kkudrolli/Team-SDK-545/background.bmp

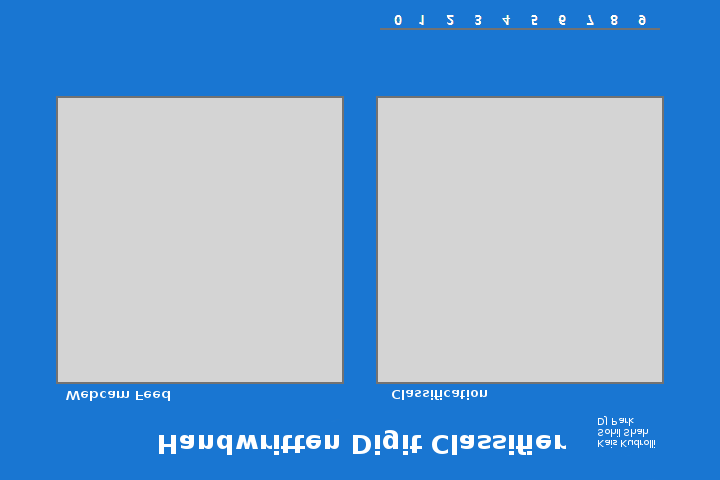
background.bmp
