kkudrolli/Team-SDK-545/labs/lab1_1/sources/lab1_top.v

`timescale 1ns / 1ps
//////////////////////////////////////////////////////////////////////////////////
// Company: 
// Engineer: 
// 
// Create Date: 09/05/2015 11:21:27 AM
// Design Name: 
// Module Name: lab1_top
// Project Name: 
// Target Devices: 
// Tool Versions: 
// Description: 
// 
// Dependencies: 
// 
// Revision:
// Revision 0.01 - File Created
// Additional Comments:
// 
//////////////////////////////////////////////////////////////////////////////////


module lab1_top(
    input logic [3:0] A,B,
    output logic [3:0] C
    );
    
    assign C = A^B;
endmodule
