kkudrolli/Team-SDK-545/rtl/hdmi/constriants/pin.xdc

set_property PACKAGE_PIN AU23 [get_ports HDMI_TX_CLK]
set_property IOSTANDARD LVCMOS18 [get_ports HDMI_TX_CLK]
set_property PACKAGE_PIN AP21 [get_ports HDMI_TX_DE]
set_property IOSTANDARD LVCMOS18 [get_ports HDMI_TX_DE]
set_property IOSTANDARD LVCMOS18 [get_ports HDMI_TX_HS]
set_property PACKAGE_PIN AT22 [get_ports HDMI_TX_VS]
set_property IOSTANDARD LVCMOS18 [get_ports HDMI_TX_VS]
set_property PACKAGE_PIN AU22 [get_ports HDMI_TX_HS]
set_property PACKAGE_PIN AT35 [get_ports I2C_SCL]
set_property IOSTANDARD LVCMOS18 [get_ports I2C_SCL]
set_property PACKAGE_PIN AU32 [get_ports I2C_SDA]
set_property IOSTANDARD LVCMOS18 [get_ports I2C_SDA]
set_property PACKAGE_PIN E19 [get_ports SYSCLK_P]
set_property IOSTANDARD LVDS [get_ports SYSCLK_P]
set_property PACKAGE_PIN AV39 [get_ports rst]
set_property IOSTANDARD LVCMOS18 [get_ports rst]

set_property PACKAGE_PIN AM22 [get_ports {HDMI_TX_D[0]}]
set_property IOSTANDARD LVCMOS18 [get_ports {HDMI_TX_D[0]}]
set_property PACKAGE_PIN AL22 [get_ports {HDMI_TX_D[1]}]
set_property IOSTANDARD LVCMOS18 [get_ports {HDMI_TX_D[1]}]
set_property PACKAGE_PIN AJ20 [get_ports {HDMI_TX_D[2]}]
set_property IOSTANDARD LVCMOS18 [get_ports {HDMI_TX_D[2]}]
set_property PACKAGE_PIN AJ21 [get_ports {HDMI_TX_D[3]}]
set_property IOSTANDARD LVCMOS18 [get_ports {HDMI_TX_D[3]}]
set_property PACKAGE_PIN AM21 [get_ports {HDMI_TX_D[4]}]
set_property IOSTANDARD LVCMOS18 [get_ports {HDMI_TX_D[4]}]
set_property PACKAGE_PIN AL21 [get_ports {HDMI_TX_D[5]}]
set_property IOSTANDARD LVCMOS18 [get_ports {HDMI_TX_D[5]}]
set_property PACKAGE_PIN AK22 [get_ports {HDMI_TX_D[6]}]
set_property IOSTANDARD LVCMOS18 [get_ports {HDMI_TX_D[6]}]
set_property PACKAGE_PIN AJ22 [get_ports {HDMI_TX_D[7]}]
set_property IOSTANDARD LVCMOS18 [get_ports {HDMI_TX_D[7]}]
set_property PACKAGE_PIN AL20 [get_ports {HDMI_TX_D[8]}]
set_property IOSTANDARD LVCMOS18 [get_ports {HDMI_TX_D[8]}]
set_property PACKAGE_PIN AK20 [get_ports {HDMI_TX_D[9]}]
set_property IOSTANDARD LVCMOS18 [get_ports {HDMI_TX_D[9]}]
set_property PACKAGE_PIN AK23 [get_ports {HDMI_TX_D[10]}]
set_property IOSTANDARD LVCMOS18 [get_ports {HDMI_TX_D[10]}]
set_property PACKAGE_PIN AJ23 [get_ports {HDMI_TX_D[11]}]
set_property IOSTANDARD LVCMOS18 [get_ports {HDMI_TX_D[11]}]
set_property PACKAGE_PIN AN21 [get_ports {HDMI_TX_D[12]}]
set_property IOSTANDARD LVCMOS18 [get_ports {HDMI_TX_D[12]}]
set_property PACKAGE_PIN AP22 [get_ports {HDMI_TX_D[13]}]
set_property IOSTANDARD LVCMOS18 [get_ports {HDMI_TX_D[13]}]
set_property PACKAGE_PIN AP23 [get_ports {HDMI_TX_D[14]}]
set_property IOSTANDARD LVCMOS18 [get_ports {HDMI_TX_D[14]}]
set_property PACKAGE_PIN AN23 [get_ports {HDMI_TX_D[15]}]
set_property IOSTANDARD LVCMOS18 [get_ports {HDMI_TX_D[15]}]
set_property PACKAGE_PIN AM23 [get_ports {HDMI_TX_D[16]}]
set_property IOSTANDARD LVCMOS18 [get_ports {HDMI_TX_D[16]}]
set_property PACKAGE_PIN AN24 [get_ports {HDMI_TX_D[17]}]
set_property IOSTANDARD LVCMOS18 [get_ports {HDMI_TX_D[17]}]
set_property PACKAGE_PIN AY24 [get_ports {HDMI_TX_D[18]}]
set_property IOSTANDARD LVCMOS18 [get_ports {HDMI_TX_D[18]}]
set_property PACKAGE_PIN BB22 [get_ports {HDMI_TX_D[19]}]
set_property IOSTANDARD LVCMOS18 [get_ports {HDMI_TX_D[19]}]
set_property PACKAGE_PIN BA22 [get_ports {HDMI_TX_D[20]}]
set_property IOSTANDARD LVCMOS18 [get_ports {HDMI_TX_D[20]}]
set_property PACKAGE_PIN BA25 [get_ports {HDMI_TX_D[21]}]
set_property IOSTANDARD LVCMOS18 [get_ports {HDMI_TX_D[21]}]
set_property PACKAGE_PIN AY25 [get_ports {HDMI_TX_D[22]}]
set_property IOSTANDARD LVCMOS18 [get_ports {HDMI_TX_D[22]}]
set_property PACKAGE_PIN AY22 [get_ports {HDMI_TX_D[23]}]
set_property IOSTANDARD LVCMOS18 [get_ports {HDMI_TX_D[23]}]
set_property PACKAGE_PIN AY23 [get_ports {HDMI_TX_D[24]}]
set_property IOSTANDARD LVCMOS18 [get_ports {HDMI_TX_D[24]}]
set_property PACKAGE_PIN AV24 [get_ports {HDMI_TX_D[25]}]
set_property IOSTANDARD LVCMOS18 [get_ports {HDMI_TX_D[25]}]
set_property PACKAGE_PIN AU24 [get_ports {HDMI_TX_D[26]}]
set_property IOSTANDARD LVCMOS18 [get_ports {HDMI_TX_D[26]}]
set_property PACKAGE_PIN AW21 [get_ports {HDMI_TX_D[27]}]
set_property IOSTANDARD LVCMOS18 [get_ports {HDMI_TX_D[27]}]
set_property PACKAGE_PIN AV21 [get_ports {HDMI_TX_D[28]}]
set_property IOSTANDARD LVCMOS18 [get_ports {HDMI_TX_D[28]}]
set_property PACKAGE_PIN AT24 [get_ports {HDMI_TX_D[29]}]
set_property IOSTANDARD LVCMOS18 [get_ports {HDMI_TX_D[29]}]
set_property PACKAGE_PIN AR24 [get_ports {HDMI_TX_D[30]}]
set_property IOSTANDARD LVCMOS18 [get_ports {HDMI_TX_D[30]}]
set_property PACKAGE_PIN AU21 [get_ports {HDMI_TX_D[31]}]
set_property IOSTANDARD LVCMOS18 [get_ports {HDMI_TX_D[31]}]
set_property PACKAGE_PIN AT21 [get_ports {HDMI_TX_D[32]}]
set_property IOSTANDARD LVCMOS18 [get_ports {HDMI_TX_D[32]}]
set_property PACKAGE_PIN AW22 [get_ports {HDMI_TX_D[33]}]
set_property IOSTANDARD LVCMOS18 [get_ports {HDMI_TX_D[33]}]
set_property PACKAGE_PIN AW23 [get_ports {HDMI_TX_D[34]}]
set_property IOSTANDARD LVCMOS18 [get_ports {HDMI_TX_D[34]}]
set_property PACKAGE_PIN AV23 [get_ports {HDMI_TX_D[35]}]
set_property IOSTANDARD LVCMOS18 [get_ports {HDMI_TX_D[35]}]
