kkudrolli/Team-SDK-545/labs/lab1_1/constraints/lab1_const.xdc

set_property IOSTANDARD LVDCI_18 [get_ports {A[3]}]
set_property IOSTANDARD LVDCI_18 [get_ports {A[2]}]
set_property IOSTANDARD LVDCI_18 [get_ports {A[1]}]
set_property IOSTANDARD LVDCI_18 [get_ports {A[0]}]
set_property IOSTANDARD LVDCI_18 [get_ports {B[3]}]
set_property IOSTANDARD LVDCI_18 [get_ports {B[2]}]
set_property IOSTANDARD LVDCI_18 [get_ports {B[1]}]
set_property IOSTANDARD LVDCI_18 [get_ports {B[0]}]
set_property PACKAGE_PIN AV30 [get_ports {A[3]}]
set_property PACKAGE_PIN AY33 [get_ports {A[2]}]
set_property PACKAGE_PIN BA31 [get_ports {A[1]}]
set_property PACKAGE_PIN BA32 [get_ports {A[0]}]
set_property PACKAGE_PIN AW30 [get_ports {B[3]}]
set_property PACKAGE_PIN AY30 [get_ports {B[2]}]
set_property PACKAGE_PIN BA30 [get_ports {B[1]}]
set_property PACKAGE_PIN BB31 [get_ports {B[0]}]
set_property PACKAGE_PIN AM39 [get_ports {C[3]}]
set_property PACKAGE_PIN AN39 [get_ports {C[2]}]
set_property PACKAGE_PIN AR37 [get_ports {C[1]}]
set_property PACKAGE_PIN AT37 [get_ports {C[0]}]
set_property IOSTANDARD LVCMOS18 [get_ports {C[3]}]
set_property IOSTANDARD LVCMOS18 [get_ports {C[2]}]
set_property IOSTANDARD LVCMOS18 [get_ports {C[1]}]
set_property IOSTANDARD LVCMOS18 [get_ports {C[0]}]
