kkudrolli/Team-SDK-545/labs/lab1_2/constraints/pin.xdc

set_property IOSTANDARD LVCMOS18 [get_ports GPIO_SW_C]
set_property IOSTANDARD LVCMOS18 [get_ports GPIO_SW_E]
set_property IOSTANDARD LVCMOS18 [get_ports GPIO_SW_S]
set_property IOSTANDARD LVCMOS18 [get_ports GPIO_SW_W]
set_property PACKAGE_PIN AV39 [get_ports GPIO_SW_C]
set_property PACKAGE_PIN AU38 [get_ports GPIO_SW_E]
set_property PACKAGE_PIN AP40 [get_ports GPIO_SW_S]
set_property PACKAGE_PIN AW40 [get_ports GPIO_SW_W]
set_property IOSTANDARD LVCMOS18 [get_ports LCD_FPGA_DB4]
set_property IOSTANDARD LVCMOS18 [get_ports LCD_FPGA_DB5]
set_property IOSTANDARD LVCMOS18 [get_ports LCD_FPGA_DB6]
set_property IOSTANDARD LVCMOS18 [get_ports LCD_FPGA_DB7]
set_property IOSTANDARD LVCMOS18 [get_ports LCD_FPGA_E]
set_property IOSTANDARD LVCMOS18 [get_ports LCD_FPGA_RS]
set_property IOSTANDARD LVCMOS18 [get_ports LCD_FPGA_RW]
set_property PACKAGE_PIN AT42 [get_ports LCD_FPGA_DB4]
set_property PACKAGE_PIN AR38 [get_ports LCD_FPGA_DB5]
set_property PACKAGE_PIN AR39 [get_ports LCD_FPGA_DB6]
set_property PACKAGE_PIN AN40 [get_ports LCD_FPGA_DB7]
set_property PACKAGE_PIN AT40 [get_ports LCD_FPGA_E]
set_property PACKAGE_PIN AN41 [get_ports LCD_FPGA_RS]
set_property PACKAGE_PIN AR42 [get_ports LCD_FPGA_RW]

set_property PACKAGE_PIN E19 [get_ports SYSCLK_P]
set_property IOSTANDARD LVDS [get_ports SYSCLK_P]
