kkudrolli/Team-SDK-545/weightProject_FP/weight/weight.srcs/sources_1/bd/weights_layer_0/hdl/weights_layer_0.v

//Copyright 1986-2015 Xilinx, Inc. All Rights Reserved.
//--------------------------------------------------------------------------------
//Tool Version: Vivado v.2015.2 (lin64) Build 1266856 Fri Jun 26 16:35:25 MDT 2015
//Date        : Tue Nov 10 17:19:07 2015
//Host        : savage.andrew.cmu.edu running 64-bit Red Hat Enterprise Linux Server release 7.1 (Maipo)
//Command     : generate_target weights_layer_0.bd
//Design      : weights_layer_0
//Purpose     : IP block netlist
//--------------------------------------------------------------------------------
`timescale 1 ps / 1 ps

(* CORE_GENERATION_INFO = "weights_layer_0,IP_Integrator,{x_ipProduct=Vivado 2015.2,x_ipVendor=xilinx.com,x_ipLibrary=BlockDiagram,x_ipName=weights_layer_0,x_ipVersion=1.00.a,x_ipLanguage=VERILOG,numBlks=128,numReposBlks=128,numNonXlnxBlks=0,numHierBlks=0,maxHierDepth=0,synth_mode=Global}" *) (* HW_HANDOFF = "weights_layer_0.hwdef" *) 
module weights_layer_0
   (BRAM_PORTA_100_addr,
    BRAM_PORTA_100_clk,
    BRAM_PORTA_100_din,
    BRAM_PORTA_100_dout,
    BRAM_PORTA_100_we,
    BRAM_PORTA_101_addr,
    BRAM_PORTA_101_clk,
    BRAM_PORTA_101_din,
    BRAM_PORTA_101_dout,
    BRAM_PORTA_101_we,
    BRAM_PORTA_102_addr,
    BRAM_PORTA_102_clk,
    BRAM_PORTA_102_din,
    BRAM_PORTA_102_dout,
    BRAM_PORTA_102_we,
    BRAM_PORTA_103_addr,
    BRAM_PORTA_103_clk,
    BRAM_PORTA_103_din,
    BRAM_PORTA_103_dout,
    BRAM_PORTA_103_we,
    BRAM_PORTA_104_addr,
    BRAM_PORTA_104_clk,
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
        .clka(BRAM_PORTA_1_65_CLK),
        .dina(BRAM_PORTA_1_65_DIN),
        .douta(BRAM_PORTA_1_65_DOUT),
        .wea(BRAM_PORTA_1_65_WE));
  weights_layer_0_blk_mem_gen_3_5 blk_mem_gen_9
       (.addra(BRAM_PORTA_3_7_ADDR),
        .clka(BRAM_PORTA_3_7_CLK),
        .dina(BRAM_PORTA_3_7_DIN),
        .douta(BRAM_PORTA_3_7_DOUT),
        .wea(BRAM_PORTA_3_7_WE));
  weights_layer_0_blk_mem_gen_27_62 blk_mem_gen_90
       (.addra(BRAM_PORTA_1_66_ADDR),
        .clka(BRAM_PORTA_1_66_CLK),
        .dina(BRAM_PORTA_1_66_DIN),
        .douta(BRAM_PORTA_1_66_DOUT),
        .wea(BRAM_PORTA_1_66_WE));
  weights_layer_0_blk_mem_gen_27_63 blk_mem_gen_91
       (.addra(BRAM_PORTA_1_67_ADDR),
        .clka(BRAM_PORTA_1_67_CLK),
        .dina(BRAM_PORTA_1_67_DIN),
        .douta(BRAM_PORTA_1_67_DOUT),
        .wea(BRAM_PORTA_1_67_WE));
  weights_layer_0_blk_mem_gen_27_64 blk_mem_gen_92
       (.addra(BRAM_PORTA_1_68_ADDR),
        .clka(BRAM_PORTA_1_68_CLK),
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
