kkudrolli/Team-SDK-545/weightProject_FP/weight/weight.srcs/sources_1/bd/weights_layer_1/hdl/weights_layer_1.v

//Copyright 1986-2015 Xilinx, Inc. All Rights Reserved.
//--------------------------------------------------------------------------------
//Tool Version: Vivado v.2015.2 (lin64) Build 1266856 Fri Jun 26 16:35:25 MDT 2015
//Date        : Tue Nov 10 17:19:02 2015
//Host        : savage.andrew.cmu.edu running 64-bit Red Hat Enterprise Linux Server release 7.1 (Maipo)
//Command     : generate_target weights_layer_1.bd
//Design      : weights_layer_1
//Purpose     : IP block netlist
//--------------------------------------------------------------------------------
`timescale 1 ps / 1 ps

(* CORE_GENERATION_INFO = "weights_layer_1,IP_Integrator,{x_ipProduct=Vivado 2015.2,x_ipVendor=xilinx.com,x_ipLibrary=BlockDiagram,x_ipName=weights_layer_1,x_ipVersion=1.00.a,x_ipLanguage=VERILOG,numBlks=10,numReposBlks=10,numNonXlnxBlks=0,numHierBlks=0,maxHierDepth=0,synth_mode=Global}" *) (* HW_HANDOFF = "weights_layer_1.hwdef" *) 
module weights_layer_1
   (BRAM_PORTA1_addr,
    BRAM_PORTA1_clk,
    BRAM_PORTA1_din,
    BRAM_PORTA1_dout,
    BRAM_PORTA1_we,
    BRAM_PORTA2_addr,
    BRAM_PORTA2_clk,
    BRAM_PORTA2_din,
    BRAM_PORTA2_dout,
    BRAM_PORTA2_we,
    BRAM_PORTA3_addr,
    BRAM_PORTA3_clk,
    BRAM_PORTA3_din,
    BRAM_PORTA3_dout,
    BRAM_PORTA3_we,
    BRAM_PORTA4_addr,
    BRAM_PORTA4_clk,
    BRAM_PORTA4_din,
    BRAM_PORTA4_dout,
    BRAM_PORTA4_we,
    BRAM_PORTA5_addr,
    BRAM_PORTA5_clk,
    BRAM_PORTA5_din,
    BRAM_PORTA5_dout,
    BRAM_PORTA5_we,
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
        .douta(BRAM_PORTA_9_DOUT),
        .wea(BRAM_PORTA_9_WE));
  weights_layer_1_blk_mem_gen_0_9 blk_mem_gen_9
       (.addra(BRAM_PORTA_10_ADDR),
        .clka(BRAM_PORTA_10_CLK),
        .dina(BRAM_PORTA_10_DIN),
        .douta(BRAM_PORTA_10_DOUT),
        .wea(BRAM_PORTA_10_WE));
endmodule
