kkudrolli/Team-SDK-545/weightProject_FP/weight/weight.srcs/sources_1/new/weight.sv

`timescale 1ns / 1ps
//////////////////////////////////////////////////////////////////////////////////
// Company: 
// Engineer: 
// 
// Create Date: 10/28/2015 12:04:15 PM
// Design Name: 
// Module Name: weight
// Project Name: 
// Target Devices: 
// Tool Versions: 
// Description: 
// 
// Dependencies: 
// 
// Revision:
// Revision 0.01 - File Created
// Additional Comments:
// 
//////////////////////////////////////////////////////////////////////////////////


module weights(input clka, rst,
              input start_0, start_1,
              output logic [127:0] [31:0] values_0,
              output logic [9:0] [31:0] values_1);
    
    logic [9:0] addra_0;
    logic [6:0] addra_1;
    logic [0:0] wea_0, wea_1;
    
    logic processing_0, processingPrev_0, processing_1, processingPrev_1;
    logic [9:0] counter_0;
    logic [7:0] counter_1;
    
    logic [127:0] [31:0] douta_0;
    logic [127:0] [31:0] dina_0;

    logic [9:0] [31:0] dina_1;
    logic [9:0] [31:0] douta_1;

    weights_layer_0_wrapper l0(
        .BRAM_PORTA_addr(addra_0),
        .BRAM_PORTA_clk(clka),
        .BRAM_PORTA_din(0),
        .BRAM_PORTA_dout(douta_0[0]),
        .BRAM_PORTA_we(0),
        .BRAM_PORTA_1_addr(addra_0),
        .BRAM_PORTA_1_clk(clka),
        .BRAM_PORTA_1_din(0),
        .BRAM_PORTA_1_dout(douta_0[1]),
        .BRAM_PORTA_1_we(0),
        .BRAM_PORTA_2_addr(addra_0),
        .BRAM_PORTA_2_clk(clka),
        .BRAM_PORTA_2_din(0),
        .BRAM_PORTA_2_dout(douta_0[2]),
        .BRAM_PORTA_2_we(0),
        .BRAM_PORTA_3_addr(addra_0),
        .BRAM_PORTA_3_clk(clka),
        .BRAM_PORTA_3_din(0),
        .BRAM_PORTA_3_dout(douta_0[3]),
        .BRAM_PORTA_3_we(0),
        .BRAM_PORTA_4_addr(addra_0),
        .BRAM_PORTA_4_clk(clka),
        .BRAM_PORTA_4_din(0),
        .BRAM_PORTA_4_dout(douta_0[4]),
        .BRAM_PORTA_4_we(0),
        .BRAM_PORTA_5_addr(addra_0),
        .BRAM_PORTA_5_clk(clka),
        .BRAM_PORTA_5_din(0),
        .BRAM_PORTA_5_dout(douta_0[5]),
        .BRAM_PORTA_5_we(0),
        .BRAM_PORTA_6_addr(addra_0),
        .BRAM_PORTA_6_clk(clka),
        .BRAM_PORTA_6_din(0),
        .BRAM_PORTA_6_dout(douta_0[6]),
        .BRAM_PORTA_6_we(0),
        .BRAM_PORTA_7_addr(addra_0),
        .BRAM_PORTA_7_clk(clka),
        .BRAM_PORTA_7_din(0),
        .BRAM_PORTA_7_dout(douta_0[7]),
        .BRAM_PORTA_7_we(0),
        .BRAM_PORTA_8_addr(addra_0),
        .BRAM_PORTA_8_clk(clka),
        .BRAM_PORTA_8_din(0),
        .BRAM_PORTA_8_dout(douta_0[8]),
        .BRAM_PORTA_8_we(0),
        .BRAM_PORTA_9_addr(addra_0),
        .BRAM_PORTA_9_clk(clka),
        .BRAM_PORTA_9_din(0),
        .BRAM_PORTA_9_dout(douta_0[9]),
        .BRAM_PORTA_9_we(0),
        .BRAM_PORTA_10_addr(addra_0),
        .BRAM_PORTA_10_clk(clka),
        .BRAM_PORTA_10_din(0),
        .BRAM_PORTA_10_dout(douta_0[10]),
        .BRAM_PORTA_10_we(0),
        .BRAM_PORTA_11_addr(addra_0),
        .BRAM_PORTA_11_clk(clka),
        .BRAM_PORTA_11_din(0),
        .BRAM_PORTA_11_dout(douta_0[11]),
        .BRAM_PORTA_11_we(0),
        .BRAM_PORTA_12_addr(addra_0),
        .BRAM_PORTA_12_clk(clka),
        .BRAM_PORTA_12_din(0),
        .BRAM_PORTA_12_dout(douta_0[12]),
        .BRAM_PORTA_12_we(0),
        .BRAM_PORTA_13_addr(addra_0),
        .BRAM_PORTA_13_clk(clka),
        .BRAM_PORTA_13_din(0),
        .BRAM_PORTA_13_dout(douta_0[13]),
        .BRAM_PORTA_13_we(0),
        .BRAM_PORTA_14_addr(addra_0),
        .BRAM_PORTA_14_clk(clka),
        .BRAM_PORTA_14_din(0),
        .BRAM_PORTA_14_dout(douta_0[14]),
        .BRAM_PORTA_14_we(0),
        .BRAM_PORTA_15_addr(addra_0),
        .BRAM_PORTA_15_clk(clka),
        .BRAM_PORTA_15_din(0),
        .BRAM_PORTA_15_dout(douta_0[15]),
        .BRAM_PORTA_15_we(0),
        .BRAM_PORTA_16_addr(addra_0),
        .BRAM_PORTA_16_clk(clka),
        .BRAM_PORTA_16_din(0),
        .BRAM_PORTA_16_dout(douta_0[16]),
        .BRAM_PORTA_16_we(0),
        .BRAM_PORTA_17_addr(addra_0),
        .BRAM_PORTA_17_clk(clka),
        .BRAM_PORTA_17_din(0),
        .BRAM_PORTA_17_dout(douta_0[17]),
        .BRAM_PORTA_17_we(0),
        .BRAM_PORTA_18_addr(addra_0),
        .BRAM_PORTA_18_clk(clka),
        .BRAM_PORTA_18_din(0),
        .BRAM_PORTA_18_dout(douta_0[18]),
        .BRAM_PORTA_18_we(0),
        .BRAM_PORTA_19_addr(addra_0),
        .BRAM_PORTA_19_clk(clka),
        .BRAM_PORTA_19_din(0),
        .BRAM_PORTA_19_dout(douta_0[19]),
        .BRAM_PORTA_19_we(0),
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
            end
        end
        else begin
            values_0 = 0;
        end
        if(processingPrev_1) begin
            for(i=0;i<10;i=i+1) begin
                values_1[i] = douta_1[i];
            end
        end
        else begin
            values_1 = 0;
        end
    end

    integer i;
    // READING
    always_ff @(posedge clka or posedge rst) begin
        if(rst) begin
            values_0 <= 0;
            values_1 <= 0;
            addra_0 <= 0;
            addra_1 <= 0;
            counter_0 <= 0;
            counter_1 <= 0;
            processing_0 <= 0;
            processing_1 <= 0;
        end
        else begin
            if(processing_0) begin // processing weight request for layer 0, 784 cycles long
                if (counter_0<784) begin
                    addra_0 <= addra_0 + 1;
                    counter_0 <= counter_0 + 1;
                end
                else if(counter_0==784) begin
                    addra_0 <= 0;
                    counter_0 <= 0;
                    processing_0 <= 0;
                end
            end
            else if(start_0) begin // weight values for layer 0 request, asserted for one cycle
                processing_0 <= 1;
                counter_0 <= counter_0 + 1;
            end            
            if(processing_1) begin // processing weight request for layer 1, 128 cycles long
                if (counter_1<128) begin
                    addra_1 <= addra_1 + 1;
                    counter_1 <= counter_1 + 1;
                end
                else if(counter_1==128) begin
                    addra_1 <= 0;
                    counter_1 <= 0;
                    processing_1 <= 0;
                end
            end
            else if(start_1) begin // weight values for layer 1 request, asserted for one cycle
                processing_1 <= 1;
                counter_1 <= counter_1 + 1;
            end
        end
    end

endmodule
/*
module test;

    logic clka, rst;
    logic start_0, start_1;
    logic [127:0] [31:0] values_0;
    logic [9:0] [31:0] values_1;

    initial begin
        clka = 0;
        forever #5 clka = ~clka;
    end

    integer i;
    weights w(clka, rst, start_0, start_1, values_0, values_1);

    initial begin
        rst = 0;
        start_0 = 0;
        start_1 = 0;
        @(posedge clka);
        rst = 1;
        @(posedge clka);
        rst = 0;
        @(posedge clka);
        @(posedge clka);
        @(posedge clka);
        start_0 = 1;
        $display("\n");
        $display("start_0\n");
        $display("values_0[125]=%d",values_0[125]); // 0
        $display("values_0[20]=%d",values_0[20]); // 0
        $display("values_1[5]=%d",values_1[5]); // 0
        $display("------------------------------");
        @(posedge clka); // 1
        start_0 = 0;
        $display("values_0[125]=%d",values_0[125]); // 0
        $display("values_0[20]=%d",values_0[20]); // 0
        $display("values_1[5]=%d",values_1[5]); // 0
        $display("------------------------------");
        @(posedge clka); // 2
        $display("values_0[125]=%d",values_0[125]); // 1
        $display("values_0[20]=%d",values_0[20]); // 1
        $display("values_1[5]=%d",values_1[5]); // 0
        $display("------------------------------");
        @(posedge clka); // 3
        $display("values_0[125]=%d",values_0[125]); // 2
        $display("values_0[20]=%d",values_0[20]); // 2
        $display("values_1[5]=%d",values_1[5]); // 0
        $display("------------------------------");
        for(i=0;i<780;i=i+1) begin
            @(posedge clka);
        end
        $display("values_0[125]=%d",values_0[125]); // 782
        $display("values_0[20]=%d",values_0[20]); // 782
        $display("values_1[5]=%d",values_1[5]); //0
        $display("------------------------------");
        @(posedge clka); // 784
        $display("values_0[125]=%d",values_0[125]); // 783
        $display("values_0[20]=%d",values_0[20]); // 783
        $display("values_1[5]=%d",values_1[5]); //0
        $display("------------------------------");
        @(posedge clka); // 785
        // done
        $display("values_0[125]=%d",values_0[125]); // 0
        $display("values_0[20]=%d",values_0[20]); // 0
        $display("values_1[5]=%d",values_1[5]); //0
        $display("------------------------------");
        $display("\n");
        @(posedge clka);
        $display("values_0[125]=%d",values_0[125]); // 0
        $display("values_0[20]=%d",values_0[20]); // 0
        $display("values_1[5]=%d",values_1[5]); //0
        $display("------------------------------");
        $display("\n");
        @(posedge clka);
        start_1 = 1;
        $display("start_1\n");
        $display("values_0[125]=%d",values_0[125]); // 0
        $display("values_0[20]=%d",values_0[20]); // 0
        $display("values_1[5]=%d",values_1[5]); // 0
        $display("------------------------------");
        @(posedge clka); // 1
        $display("values_0[125]=%d",values_0[125]); // 0
        $display("values_0[20]=%d",values_0[20]); // 0
        $display("values_1[5]=%d",values_1[5]); // 0
        $display("------------------------------");
        start_1 = 0;
        @(posedge clka); // 2
        $display("values_0[125]=%d",values_0[125]); // 0
        $display("values_0[20]=%d",values_0[20]); // 0
        $display("values_1[5]=%d",values_1[5]); // 1
        $display("------------------------------");
        @(posedge clka); // 3
        for(i=0;i<125;i=i+1) begin
            @(posedge clka);
        end
        $display("values_0[125]=%d",values_0[125]); // 0
        $display("values_0[20]=%d",values_0[20]); // 0
        $display("values_1[5]=%d",values_1[5]); // 127 
        $display("------------------------------");
        @(posedge clka); // 129
        $display("values_0[125]=%d",values_0[125]); // 0
        $display("values_0[20]=%d",values_0[20]); // 0
        $display("values_1[5]=%d",values_1[5]); // 0
        $display("------------------------------");
        @(posedge clka);
        $display("values_0[125]=%d",values_0[125]); // 0
        $display("values_0[20]=%d",values_0[20]); // 0
        $display("values_1[5]=%d",values_1[5]); // 0
        $display("------------------------------");
        $display("\n");
        @(posedge clka);
        @(posedge clka);
        @(posedge clka);
        $finish;
    end

endmodule*/
