kkudrolli/Team-SDK-545/sw/image/src/err_wrappers.h

/*
 * Author: Kais Kudrolli
 *
 * Description: The header file for err_wrappers.c.
 *
 */

#ifndef _ERR_WRAPPERS_H_
#define _ERR_WRAPPERS_H_

#include <stdio.h>
#include <string.h>
#include <errno.h>
#include <stdlib.h>
#include <sys/types.h>
#include <dirent.h>

/* Function defintions */
void error_print(char *err_msg);
FILE *Fopen(const char *filename, const char *mode);
size_t Fread(void *ptr, size_t size, size_t nmemb, FILE *stream); 
void Fclose(FILE *fp); 
void *Malloc(size_t size); 
void *Realloc(void *ptr, size_t size);
void *Calloc(size_t nmemb, size_t size); 
void Free(void *ptr);
DIR *Opendir(const char *filename);
struct dirent *Readdir(DIR *dirp);
int Closedir(DIR *dirp);

#endif
