kkudrolli/Team-SDK-545/hdmi_test/hdmi_test.srcs/sources_1/new/weights.sv

`timescale 1ns / 1ps

/**
 * A cycle after update is asserted, deltaWeights are applied.
 */
module weights(input clka, rst,
              input start_0, start_1, update_0, update_1,
              input [4095:0] deltaWeights_0,
              input [319:0] deltaWeights_1,
              output logic [4095:0] values_0,
              output logic [319:0] values_1);
    
    logic [9:0] addra_0,addra_0_write;
    logic [6:0] addra_1,addra_1_write;
    
    logic processing_0, processingPrev_0, processing_1, processingPrev_1, 
          processing_update_0, processing_updatePrev_0, processing_update_1, processing_updatePrev_1;
    logic [9:0] counter_0;
    logic [7:0] counter_1;
    
    logic [4095:0] douta_0, dina_0, douta_notUsed_0;
    logic [319:0] douta_1, dina_1, douta_notUsed_1;
  
    weights_0_wrapper w0(.BRAM_PORTA_addr(addra_0),.BRAM_PORTA_clk(clka),.BRAM_PORTA_din(4096'b0),.BRAM_PORTA_dout(douta_0),.BRAM_PORTA_we(1'b0), //  reading port
                        .BRAM_PORTB_addr(addra_0_write),.BRAM_PORTB_clk(clka),.BRAM_PORTB_din(dina_0),.BRAM_PORTB_dout(douta_0_notUsed),.BRAM_PORTB_we(processing_updatePrev_0)); // writing port

    weights_1_wrapper w1(.BRAM_PORTA_addr(addra_1),.BRAM_PORTA_clk(clka),.BRAM_PORTA_din(320'b0),.BRAM_PORTA_dout(douta_1),.BRAM_PORTA_we(1'b0), // reading port
                        .BRAM_PORTB_addr(addra_1_write),.BRAM_PORTB_clk(clka),.BRAM_PORTB_din(dina_1),.BRAM_PORTB_dout(douta_1_notUsed),.BRAM_PORTB_we(processing_updatePrev_1)); // writing port

    always_ff @(posedge clka) begin // processingPrev is the value of processing signal one cycle before
        processingPrev_0 <= processing_0;
        processingPrev_1 <= processing_1;
        processing_updatePrev_0 <= processing_update_0;
        addra_0_write <= addra_0;
        processing_updatePrev_1 <= processing_update_1;
        addra_1_write <= addra_1;
    end

    // output logic
    always_comb begin
        if(processingPrev_0) begin
            values_0 = douta_0;
        end
        else begin
            values_0 = 0;
        end
        if(processingPrev_1) begin
            values_1 = douta_1;
        end
        else begin
            values_1 = 0;
        end
    end
    
    always_comb begin
        if(processing_updatePrev_0) begin
            dina_0[31:0] = douta_0[31:0]+deltaWeights_0[31:0];
            dina_0[63:32] = douta_0[63:32]+deltaWeights_0[63:32];
            dina_0[95:64] = douta_0[95:64]+deltaWeights_0[95:64];
            dina_0[127:96] = douta_0[127:96]+deltaWeights_0[127:96];
            dina_0[159:128] = douta_0[159:128]+deltaWeights_0[159:128];
            dina_0[191:160] = douta_0[191:160]+deltaWeights_0[191:160];
            dina_0[223:192] = douta_0[223:192]+deltaWeights_0[223:192];
            dina_0[255:224] = douta_0[255:224]+deltaWeights_0[255:224];
            dina_0[287:256] = douta_0[287:256]+deltaWeights_0[287:256];
            dina_0[319:288] = douta_0[319:288]+deltaWeights_0[319:288];
            dina_0[351:320] = douta_0[351:320]+deltaWeights_0[351:320];
            dina_0[383:352] = douta_0[383:352]+deltaWeights_0[383:352];
            dina_0[415:384] = douta_0[415:384]+deltaWeights_0[415:384];
            dina_0[447:416] = douta_0[447:416]+deltaWeights_0[447:416];
            dina_0[479:448] = douta_0[479:448]+deltaWeights_0[479:448];
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
            @(posedge clka);
        end
        @(posedge clka);
        @(posedge clka);
        @(posedge clka);
        @(posedge clka);
        start_0 = 1;
        @(posedge clka);
        start_0 = 0;
        for(i=0;i<790;i=i+1) begin
            @(posedge clka);
        end
        @(posedge clka);
        @(posedge clka);
        
        $finish;
    end
endmodule
*/
