kkudrolli/Team-SDK-545/hdmi_test/hdmi_test.srcs/sources_1/imports/gameboy/num_to_image.sv

`define NUM0 'hffffffffffffffffffffffffffffffffffffffffffffffffffffffffffffffffffffffffffffffffffffffffffffffffffffffffffffffffffffffffffffffffffffffffffffffffffffffffffffffffffffffffffffffffffffffffffffffffffffffffffffffffffffffffffffffffffffffffffffffffffffff0000000000ffffffffffffffffffffffffffffffffffffffffffff0000000000000000ffffffffffffffffffffffffffffffffffffff00000000ffff00000000ffffffffffffffffffffffffffffffffffff000000ffffffff000000ffffffffffffffffffffffffffffffffff00000000ffffffff000000ffffffffffffffffffffffffffffffffff000000ffffffffff000000ffffffffffffffffffffffffffffffff00000000ffffffffff00000000ffffffffffffffffffffffffffffff00000000ffffffffff00000000ffffffffffffffffffffffffffffff00000000ffffffffff00000000ffffffffffffffffffffffffffffff00000000ffffffffff00000000ffffffffffffffffffffffffffffff00000000ffffffffff00000000ffffffffffffffffffffffffffffff00000000ffffffffff00000000ffffffffffffffffffffffffffffffff000000ffffffffff000000ffffffffffffffffffffffffffffffffff000000ffffffffff000000ffffffffffffffffffffffffffffffffff00000000ffffffff000000ffffffffffffffffffffffffffffffffffff000000ffffffff000000ffffffffffffffffffffffffffffffffffff00000000ffff00000000ffffffffffffffffffffffffffffffffffffff00000000000000ffffffffffffffffffffffffffffffffffffffffffffff00000000fffffffffffffffffffffffffffffffffffffffffffffffffffffffffffffffffffffffffffffffffffffffffffffffffffffffffffffffffffffffffffffffffffffffffffffffffffffffffffffffffffffffffffffffffffffffffffffffffffffffffffffffffffffffffffff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
`define NUM9 'hffffffffffffffffffffffffffffffffffffffffffffffffffffffffffffffffffffffffffffffffffffffffffffffffffffffffffffffffffffffffffffffffffffffffffffffffffffffffffffffffffffffffffffffffffffffffffffffffffffffffffffffffffffffffffffffffffffffffffffffffffffffffffffffffffffffffffffffffffffffffffffffffffffffffffffffffffffffffff0000ffffffffffffffffffffffffffffffffffffffffffffff0000000000ffffffffffffffffffffffffffffffffffffffffffff00000000ffffffffffffffffffffffffffffffffffffffffffff00000000ffffffffffffffffffffffffffffffffffffffffffffff00000000ffffffffffffffffffffffffffffffffffffffffffffffff000000ffffffffffffffffffffffffffffffffffffffffffffffff00000000ffffffffffffffffffffffffffffffffffffffffffffff0000000000000000ffffffffffffffffffffffffffffffffffffffff00000000000000000000ffffffffffffffffffffffffffffffffff000000000000000000000000ffffffffffffffffffffffffffffffff0000000000ffffff00000000ffffffffffffffffffffffffffffffff00000000ffffffffff000000ffffffffffffffffffffffffffffffff00000000ffffffffff000000ffffffffffffffffffffffffffffffff00000000ffffffffff000000ffffffffffffffffffffffffffffffff00000000ffffffffff000000ffffffffffffffffffffffffffffffffff000000ffffffffff000000ffffffffffffffffffffffffffffffffff00000000ffffffff000000ffffffffffffffffffffffffffffffffffff00000000ffff00000000ffffffffffffffffffffffffffffffffffffff0000000000000000ffffffffffffffffffffffffffffffffffffffffff0000000000ffffffffffffffffffffffffffffffffffffffffffffffffffffffffffffffffffffffffffffffffffffffffffffffffffffffffffffffffffffffffffffffffffffffffffffffffffffffffffffffffffffffffffffffffffffffffffffffff

module num_to_image(
    input  logic [3:0]          num,
    output logic [(784<<3)-1:0] image);

    always_comb begin
        case (num)
            4'd0: image = `NUM0; 
            4'd1: image = `NUM1;
            4'd2: image = `NUM2;
            4'd3: image = `NUM3;
            4'd4: image = `NUM4;
            4'd5: image = `NUM5;
            4'd6: image = `NUM6;
            4'd7: image = `NUM7;
            4'd8: image = `NUM8;
            4'd9: image = `NUM9;
            default: image = 'd0;
        endcase
    end

endmodule: num_to_image
