kkudrolli/Team-SDK-545/hdmi_test/hdmi_test.srcs/sources_1/bd/clock/ip/clock_clk_wiz_0_0/clock_clk_wiz_0_0_funcsim.vhdl

-- Copyright 1986-2015 Xilinx, Inc. All Rights Reserved.
-- --------------------------------------------------------------------------------
-- Tool Version: Vivado v.2015.2 (lin64) Build 1266856 Fri Jun 26 16:35:25 MDT 2015
-- Date        : Mon Nov 16 21:41:04 2015
-- Host        : horizon.andrew.cmu.edu running 64-bit Red Hat Enterprise Linux Server release 7.1 (Maipo)
-- Command     : write_vhdl -force -mode funcsim
--               /afs/ece.cmu.edu/usr/sohils/Private/18545/deep/hdmi_test/hdmi_test.srcs/sources_1/bd/clock/ip/clock_clk_wiz_0_0/clock_clk_wiz_0_0_funcsim.vhdl
-- Design      : clock_clk_wiz_0_0
-- Purpose     : This VHDL netlist is a functional simulation representation of the design and should not be modified or
--               synthesized. This netlist cannot be used for SDF annotated simulation.
-- Device      : xc7vx485tffg1761-2
-- --------------------------------------------------------------------------------
library IEEE;
use IEEE.STD_LOGIC_1164.ALL;
library UNISIM;
use UNISIM.VCOMPONENTS.ALL;
entity clock_clk_wiz_0_0_clock_clk_wiz_0_0_clk_wiz is
  port (
    clk_in1 : in STD_LOGIC;
    clk_out1 : out STD_LOGIC;
    clk_out2 : out STD_LOGIC;
    clk_out3 : out STD_LOGIC;
    reset : in STD_LOGIC
  );
  attribute ORIG_REF_NAME : string;
  attribute ORIG_REF_NAME of clock_clk_wiz_0_0_clock_clk_wiz_0_0_clk_wiz : entity is "clock_clk_wiz_0_0_clk_wiz";
end clock_clk_wiz_0_0_clock_clk_wiz_0_0_clk_wiz;

architecture STRUCTURE of clock_clk_wiz_0_0_clock_clk_wiz_0_0_clk_wiz is
  signal clk_in1_clock_clk_wiz_0_0 : STD_LOGIC;
  signal clk_out1_clock_clk_wiz_0_0 : STD_LOGIC;
  signal clk_out2_clock_clk_wiz_0_0 : STD_LOGIC;
  signal clk_out3_clock_clk_wiz_0_0 : STD_LOGIC;
  signal clkfbout_buf_clock_clk_wiz_0_0 : STD_LOGIC;
  signal clkfbout_clock_clk_wiz_0_0 : STD_LOGIC;
  signal NLW_mmcm_adv_inst_CLKFBOUTB_UNCONNECTED : STD_LOGIC;
  signal NLW_mmcm_adv_inst_CLKFBSTOPPED_UNCONNECTED : STD_LOGIC;
  signal NLW_mmcm_adv_inst_CLKINSTOPPED_UNCONNECTED : STD_LOGIC;
  signal NLW_mmcm_adv_inst_CLKOUT0B_UNCONNECTED : STD_LOGIC;
  signal NLW_mmcm_adv_inst_CLKOUT1B_UNCONNECTED : STD_LOGIC;
  signal NLW_mmcm_adv_inst_CLKOUT2B_UNCONNECTED : STD_LOGIC;
  signal NLW_mmcm_adv_inst_CLKOUT3_UNCONNECTED : STD_LOGIC;
  signal NLW_mmcm_adv_inst_CLKOUT3B_UNCONNECTED : STD_LOGIC;
  signal NLW_mmcm_adv_inst_CLKOUT4_UNCONNECTED : STD_LOGIC;
  signal NLW_mmcm_adv_inst_CLKOUT5_UNCONNECTED : STD_LOGIC;
  signal NLW_mmcm_adv_inst_CLKOUT6_UNCONNECTED : STD_LOGIC;
  signal NLW_mmcm_adv_inst_DRDY_UNCONNECTED : STD_LOGIC;
  signal NLW_mmcm_adv_inst_LOCKED_UNCONNECTED : STD_LOGIC;
  signal NLW_mmcm_adv_inst_PSDONE_UNCONNECTED : STD_LOGIC;
  signal NLW_mmcm_adv_inst_DO_UNCONNECTED : STD_LOGIC_VECTOR ( 15 downto 0 );
  attribute BOX_TYPE : string;
  attribute BOX_TYPE of clkf_buf : label is "PRIMITIVE";
  attribute BOX_TYPE of clkin1_ibufg : label is "PRIMITIVE";
  attribute CAPACITANCE : string;
  attribute CAPACITANCE of clkin1_ibufg : label is "DONT_CARE";
  attribute IBUF_DELAY_VALUE : string;
  attribute IBUF_DELAY_VALUE of clkin1_ibufg : label is "0";
  attribute IFD_DELAY_VALUE : string;
  attribute IFD_DELAY_VALUE of clkin1_ibufg : label is "AUTO";
  attribute BOX_TYPE of clkout1_buf : label is "PRIMITIVE";
  attribute BOX_TYPE of clkout2_buf : label is "PRIMITIVE";
  attribute BOX_TYPE of clkout3_buf : label is "PRIMITIVE";
  attribute BOX_TYPE of mmcm_adv_inst : label is "PRIMITIVE";
begin
clkf_buf: unisim.vcomponents.BUFG
     port map (
      I => clkfbout_clock_clk_wiz_0_0,
      O => clkfbout_buf_clock_clk_wiz_0_0
    );
clkin1_ibufg: unisim.vcomponents.IBUF
    generic map(
      IOSTANDARD => "DEFAULT"
    )
        port map (
      I => clk_in1,
      O => clk_in1_clock_clk_wiz_0_0
    );
clkout1_buf: unisim.vcomponents.BUFG
     port map (
      I => clk_out1_clock_clk_wiz_0_0,
      O => clk_out1
    );
clkout2_buf: unisim.vcomponents.BUFG
     port map (
      I => clk_out2_clock_clk_wiz_0_0,
      O => clk_out2
    );
clkout3_buf: unisim.vcomponents.BUFG
     port map (
      I => clk_out3_clock_clk_wiz_0_0,
      O => clk_out3
    );
mmcm_adv_inst: unisim.vcomponents.MMCME2_ADV
    generic map(
      BANDWIDTH => "OPTIMIZED",
      CLKFBOUT_MULT_F => 3.125000,
      CLKFBOUT_PHASE => 0.000000,
      CLKFBOUT_USE_FINE_PS => false,
      CLKIN1_PERIOD => 5.000000,
      CLKIN2_PERIOD => 0.000000,
      CLKOUT0_DIVIDE_F => 23.125000,
      CLKOUT0_DUTY_CYCLE => 0.500000,
      CLKOUT0_PHASE => 0.000000,
      CLKOUT0_USE_FINE_PS => false,
      CLKOUT1_DIVIDE => 125,
      CLKOUT1_DUTY_CYCLE => 0.500000,
      CLKOUT1_PHASE => 0.000000,
      CLKOUT1_USE_FINE_PS => false,
      CLKOUT2_DIVIDE => 42,
      CLKOUT2_DUTY_CYCLE => 0.500000,
      CLKOUT2_PHASE => 0.000000,
      CLKOUT2_USE_FINE_PS => false,
      CLKOUT3_DIVIDE => 1,
      CLKOUT3_DUTY_CYCLE => 0.500000,
      CLKOUT3_PHASE => 0.000000,
      CLKOUT3_USE_FINE_PS => false,
      CLKOUT4_CASCADE => false,
      CLKOUT4_DIVIDE => 1,
      CLKOUT4_DUTY_CYCLE => 0.500000,
      CLKOUT4_PHASE => 0.000000,
      CLKOUT4_USE_FINE_PS => false,
      CLKOUT5_DIVIDE => 1,
      CLKOUT5_DUTY_CYCLE => 0.500000,
      CLKOUT5_PHASE => 0.000000,
      CLKOUT5_USE_FINE_PS => false,
      CLKOUT6_DIVIDE => 1,
      CLKOUT6_DUTY_CYCLE => 0.500000,
      CLKOUT6_PHASE => 0.000000,
      CLKOUT6_USE_FINE_PS => false,
      COMPENSATION => "ZHOLD",
      DIVCLK_DIVIDE => 1,
      IS_CLKINSEL_INVERTED => '0',
      IS_PSEN_INVERTED => '0',
      IS_PSINCDEC_INVERTED => '0',
      IS_PWRDWN_INVERTED => '0',
      IS_RST_INVERTED => '0',
      REF_JITTER1 => 0.010000,
      REF_JITTER2 => 0.010000,
      SS_EN => "FALSE",
      SS_MODE => "CENTER_HIGH",
      SS_MOD_PERIOD => 10000,
      STARTUP_WAIT => false
    )
        port map (
      CLKFBIN => clkfbout_buf_clock_clk_wiz_0_0,
      CLKFBOUT => clkfbout_clock_clk_wiz_0_0,
      CLKFBOUTB => NLW_mmcm_adv_inst_CLKFBOUTB_UNCONNECTED,
      CLKFBSTOPPED => NLW_mmcm_adv_inst_CLKFBSTOPPED_UNCONNECTED,
      CLKIN1 => clk_in1_clock_clk_wiz_0_0,
      CLKIN2 => '0',
      CLKINSEL => '1',
      CLKINSTOPPED => NLW_mmcm_adv_inst_CLKINSTOPPED_UNCONNECTED,
      CLKOUT0 => clk_out1_clock_clk_wiz_0_0,
      CLKOUT0B => NLW_mmcm_adv_inst_CLKOUT0B_UNCONNECTED,
      CLKOUT1 => clk_out2_clock_clk_wiz_0_0,
      CLKOUT1B => NLW_mmcm_adv_inst_CLKOUT1B_UNCONNECTED,
      CLKOUT2 => clk_out3_clock_clk_wiz_0_0,
      CLKOUT2B => NLW_mmcm_adv_inst_CLKOUT2B_UNCONNECTED,
      CLKOUT3 => NLW_mmcm_adv_inst_CLKOUT3_UNCONNECTED,
      CLKOUT3B => NLW_mmcm_adv_inst_CLKOUT3B_UNCONNECTED,
      CLKOUT4 => NLW_mmcm_adv_inst_CLKOUT4_UNCONNECTED,
      CLKOUT5 => NLW_mmcm_adv_inst_CLKOUT5_UNCONNECTED,
      CLKOUT6 => NLW_mmcm_adv_inst_CLKOUT6_UNCONNECTED,
      DADDR(6) => '0',
      DADDR(5) => '0',
      DADDR(4) => '0',
      DADDR(3) => '0',
      DADDR(2) => '0',
      DADDR(1) => '0',
      DADDR(0) => '0',
      DCLK => '0',
      DEN => '0',
      DI(15) => '0',
      DI(14) => '0',
      DI(13) => '0',
      DI(12) => '0',
      DI(11) => '0',
      DI(10) => '0',
      DI(9) => '0',
      DI(8) => '0',
      DI(7) => '0',
      DI(6) => '0',
      DI(5) => '0',
      DI(4) => '0',
      DI(3) => '0',
      DI(2) => '0',
      DI(1) => '0',
      DI(0) => '0',
      DO(15 downto 0) => NLW_mmcm_adv_inst_DO_UNCONNECTED(15 downto 0),
      DRDY => NLW_mmcm_adv_inst_DRDY_UNCONNECTED,
      DWE => '0',
      LOCKED => NLW_mmcm_adv_inst_LOCKED_UNCONNECTED,
      PSCLK => '0',
      PSDONE => NLW_mmcm_adv_inst_PSDONE_UNCONNECTED,
      PSEN => '0',
      PSINCDEC => '0',
      PWRDWN => '0',
      RST => reset
    );
end STRUCTURE;
library IEEE;
use IEEE.STD_LOGIC_1164.ALL;
library UNISIM;
use UNISIM.VCOMPONENTS.ALL;
entity clock_clk_wiz_0_0 is
  port (
    clk_in1 : in STD_LOGIC;
    clk_out1 : out STD_LOGIC;
    clk_out2 : out STD_LOGIC;
    clk_out3 : out STD_LOGIC;
    reset : in STD_LOGIC
  );
  attribute NotValidForBitStream : boolean;
  attribute NotValidForBitStream of clock_clk_wiz_0_0 : entity is true;
  attribute CORE_GENERATION_INFO : string;
  attribute CORE_GENERATION_INFO of clock_clk_wiz_0_0 : entity is "clock_clk_wiz_0_0,clk_wiz_v5_1,{component_name=clock_clk_wiz_0_0,use_phase_alignment=true,use_min_o_jitter=false,use_max_i_jitter=false,use_dyn_phase_shift=false,use_inclk_switchover=false,use_dyn_reconfig=false,enable_axi=0,feedback_source=FDBK_AUTO,PRIMITIVE=MMCM,num_out_clk=3,clkin1_period=5.0,clkin2_period=10.0,use_power_down=false,use_reset=true,use_locked=false,use_inclk_stopped=false,feedback_type=SINGLE,CLOCK_MGR_TYPE=NA,manual_override=false}";
end clock_clk_wiz_0_0;

architecture STRUCTURE of clock_clk_wiz_0_0 is
begin
inst: entity work.clock_clk_wiz_0_0_clock_clk_wiz_0_0_clk_wiz
     port map (
      clk_in1 => clk_in1,
      clk_out1 => clk_out1,
      clk_out2 => clk_out2,
      clk_out3 => clk_out3,
      reset => reset
    );
end STRUCTURE;
