kkudrolli/Team-SDK-545/hdmi_test/hdmi_test.srcs/sources_1/bd/clock/hdl/clock.v

//Copyright 1986-2015 Xilinx, Inc. All Rights Reserved.
//--------------------------------------------------------------------------------
//Tool Version: Vivado v.2015.2 (lin64) Build 1266856 Fri Jun 26 16:35:25 MDT 2015
//Date        : Tue Dec  8 15:22:55 2015
//Host        : horizon.andrew.cmu.edu running 64-bit Red Hat Enterprise Linux Server release 7.2 (Maipo)
//Command     : generate_target clock.bd
//Design      : clock
//Purpose     : IP block netlist
//--------------------------------------------------------------------------------
`timescale 1 ps / 1 ps

(* CORE_GENERATION_INFO = "clock,IP_Integrator,{x_ipProduct=Vivado 2015.2,x_ipVendor=xilinx.com,x_ipLibrary=BlockDiagram,x_ipName=clock,x_ipVersion=1.00.a,x_ipLanguage=VERILOG,numBlks=1,numReposBlks=1,numNonXlnxBlks=0,numHierBlks=0,maxHierDepth=0,synth_mode=Global}" *) (* HW_HANDOFF = "clock.hwdef" *) 
module clock
   (clk_in1,
    clk_out1,
    clk_out2,
    clk_out3,
    clk_out4,
    reset);
  input clk_in1;
  output clk_out1;
  output clk_out2;
  output clk_out3;
  output clk_out4;
  input reset;

  wire clk_in1_1;
  wire clk_wiz_0_clk_out1;
  wire clk_wiz_0_clk_out2;
  wire clk_wiz_0_clk_out3;
  wire clk_wiz_0_clk_out4;
  wire reset_1;

  assign clk_in1_1 = clk_in1;
  assign clk_out1 = clk_wiz_0_clk_out1;
  assign clk_out2 = clk_wiz_0_clk_out2;
  assign clk_out3 = clk_wiz_0_clk_out3;
  assign clk_out4 = clk_wiz_0_clk_out4;
  assign reset_1 = reset;
  clock_clk_wiz_0_0 clk_wiz_0
       (.clk_in1(clk_in1_1),
        .clk_out1(clk_wiz_0_clk_out1),
        .clk_out2(clk_wiz_0_clk_out2),
        .clk_out3(clk_wiz_0_clk_out3),
        .clk_out4(clk_wiz_0_clk_out4),
        .reset(reset_1));
endmodule
