kkudrolli/Team-SDK-545/(commit log)

2015-09-15 [File structure] Added sw, camera, eth, hdmi dirs
2015-09-16 [Camera] snapshot.py can take a picture using webcam and write it to a file
2015-09-19 [i2c/hdmi] working i2c microcode: accesses vc707 i2c bridge
2015-09-22 [Camera] Changed grayscale code to use naive averaging, fixed waitKey hack, added code to normalize and resize capture before storing
2015-09-23 [Sim] Added error wrappers, modified image_io slightly but incomplete, WILL NOT COMPILE YET, but you need the wrappers, set up main
    [err_wrappers.c, err_wrappers.h, image_io.c, image_io.h]
2015-09-23 [Sim] Fixed make to not use -Werror and to use c99, add code to read files in dir, loop over files and call read_bitmap
    [err_wrappers.c, err_wrappers.h, image_io.c, image_io.h]
2015-09-26 [Sim, Camera] Updated Image IO to get bitmap data and remove all the GR out of BGR, camera takes pics at 40x23 resolution now
2015-09-28 [sim_main] fixes to make it compile
    [image_io.h]
2015-10-01 [Training] Adding train.c and .h and mnist.c and .h, deleted some debug prints in image_io.c
2015-10-04 [UART] Added code to write images to uart
2015-10-05 [UART] Added MNIST test for uart to fpga in uart_main.c, updated gitignore
2015-10-07 [tile] fixed image evaluation to use weights file
    [vector.c]
2015-10-11 [forward prop] functional forward propagation
2015-10-11 [Sim] Working fwd prop sim, commented out main in activation_fns.c
2015-10-11 [Image IO] Fixed memory leaks in image_io.c and mnist.c
    [image_io.c, mnist.c]
2015-10-11 [memory leaks] fixed memory leaks
    [mnist.c]
2015-10-13 [backprop] fixed fixed point math/other things
    [vector.c, vector.h]
2015-10-16 [UART] Changed baud rate back to 9600
2015-10-20 [uart] design review demo
2015-10-29 [UART] Added sv code to implement a uart protocol for receiving image data
2015-11-01 [UART] Fully implemented (but not tested) uart hw layer, added protocol fsm, transfer and receive, synch and transfer with control unit
2015-11-01 [UART] Wrote sw to transfer based on protocol, resend and receive acks, still need to test :(, updated protocol fsm to read label
2015-11-01 [Tests] Tested control_trans_synch, control_unit, ones_comp_add, uart_clock_divider, uart_control_synch
2015-11-02 [Protocol FSM] Tested and fixed uart protocol fsm
    [uart_protocol.sv, uart_protocol_tb.sv]
2015-11-02 [UART recv] Fixed error in uart_recv: read 9 bits, so it always read in the stop bit into the byte
    [uart_recv.sv, uart_recv_tb.sv]
2015-11-02 [UART trans] Fixed uart trans, it didn't ever reach a stop condition
    [uart_trans.sv, uart_trans_tb.sv]
2015-11-02 [UART] Hooked up all uart modules and control_unit in chip_interface.sv
2015-11-02 init script and sample txts
2015-11-04 [rtl] weights.sv for FP, bug free
    [weights.sv]
2015-11-09 [verilator forward prop] functional forward prop in verilator sim
2015-11-09 [UART] Added uart handling code to hdmi_test
2015-11-10 [Camera] Updated readme in camera with opencv installation, removed usb stuff
2015-11-10 [Camera] Added thresholding to video.py
2015-11-10 [Camera] Changed threshold in video.py
2015-11-10 [Camera] Thresholds
2015-11-12 [Camera] Added code in C and python to send image directly from camera app
2015-11-17 [SW-HW Transfer] UART works, so does live feed and python-initiated transfer
2015-11-17 [synth] working on synthesis... problem with sigmoid
    [activation_fns.sv, chipinterface.sv, clock.v, clock_clk_wiz_0_0.v, clock_clk_wiz_0_0_clk_wiz.v]
2015-11-21 [Draw prediction] Change chipinterface.sv to draw prediction after a fwd prop
2015-11-21 [Duplication] Fixed some duplication of declarations in chipinterface.sv
    [chipinterface.sv, num_to_image.sv]
2015-11-21 [Chipinterface] minor declaration fix
    [chipinterface.sv]
2015-11-22 [NN test] Updated chipinterface to display prediction, corrected hdmi issue, got rid of webtalk junk
    [chipinterface.sv]
2015-11-22 [Pred imgs] Fixed port issue in num_to_image.sv
    [num_to_image.sv]
2015-11-22 [activation_fn.sv] some bug fixes there
    [activation_fns.sv, chipinterface.sv, deep.sv, num_to_image.sv, tile.sv]
2015-11-22 [Synch] Fixed done synch
    [activation_fns.sv, chipinterface.sv]
2015-11-23 [UART feed] chipinterface.sv has fix for uart feed not showing
    [chipinterface.sv]
2015-11-24 [Display] Display works now, both UART and prediction display
2015-11-30 [NN] Misc fixes and changes, fixed issue in deep where shift might zero out the image
    [chipinterface.sv, control_unit.sv, deep.sv, neuron.sv, tile.sv, weights.sv]
2015-12-03 [backprop] couple backprop stuff added
