kkudrolli/Team-SDK-545/(notices)

Notices in the files:
hdmi_test/hdmi_test.srcs/sources_1/imports/gameboy/constants.sv:
This program is free software: you can redistribute it and/or modify
it under the terms of the GNU General Public License as published by
the Free Software Foundation, either version 3 of the License, or
(at your option) any later version.
